apuder/TRS-IO/kicad/pmod/lb-80/lb-80.kicad_pcb

## KiCad design kicad/pmod/lb-80/lb-80.kicad_pcb (2024-11-14)

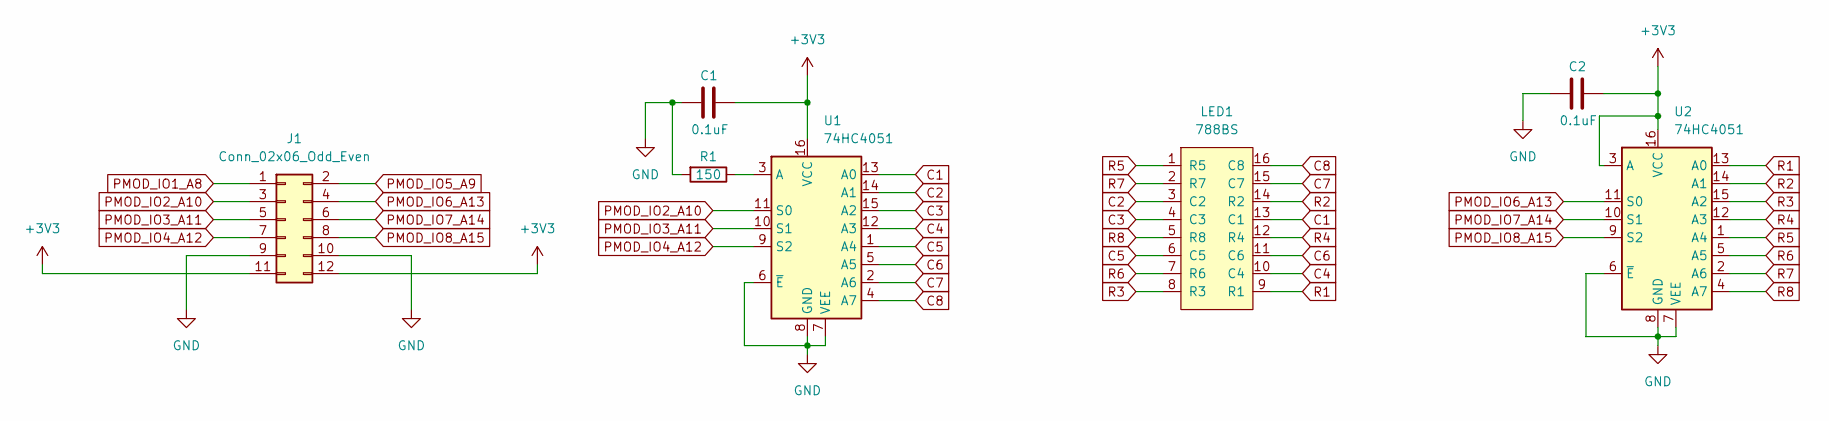
[picture p4: schematic lb-80.kicad_sch, LightBright-80]

Parts:
C1, C2: 0.1uF; C_0805_2012Metric_Pad1.18x1.45mm_HandSolder
J1: Conn_02x06_Odd_Even; PinSocket_2x06_P2.54mm_Vertical; LCSC C358728
LED1: 788BS
R1: 150; R_0805_2012Metric_Pad1.20x1.40mm_HandSolder
U1, U2: 74HC4051; TSSOP-16_4.4x5mm_P0.65mm; LCSC C352826

Connections:
+3V3: C1.1, C2.1, J1.11, J1.12, U1.16 (VCC), U2.3 (A), U2.16 (VCC)
C1: LED1.13 (C1), U1.13 (A0)
C2: LED1.3 (C2), U1.14 (A1)
C3: LED1.4 (C3), U1.15 (A2)
C4: LED1.10 (C4), U1.12 (A3)
C5: LED1.6 (C5), U1.1 (A4)
C6: LED1.11 (C6), U1.5 (A5)
C7: LED1.15 (C7), U1.2 (A6)
C8: LED1.16 (C8), U1.4 (A7)
GND: C1.2, C2.2, J1.9, J1.10, R1.2, U1.6 (~E), U1.7 (VEE), U1.8 (GND), U2.6 (~E), U2.7 (VEE), U2.8 (GND)
unnamed: R1.1, U1.3 (A)
PMOD_IO1_A8: J1.1
PMOD_IO2_A10: J1.3, U1.11 (S0)
PMOD_IO3_A11: J1.5, U1.10 (S1)
PMOD_IO4_A12: J1.7, U1.9 (S2)
PMOD_IO5_A9: J1.2
PMOD_IO6_A13: J1.4, U2.11 (S0)
PMOD_IO7_A14: J1.6, U2.10 (S1)
PMOD_IO8_A15: J1.8, U2.9 (S2)
R1: LED1.9 (R1), U2.13 (A0)
R2: LED1.14 (R2), U2.14 (A1)
R3: LED1.8 (R3), U2.15 (A2)
R4: LED1.12 (R4), U2.12 (A3)
R5: LED1.1 (R5), U2.1 (A4)
R6: LED1.7 (R6), U2.5 (A5)
R7: LED1.2 (R7), U2.2 (A6)
R8: LED1.5 (R8), U2.4 (A7)

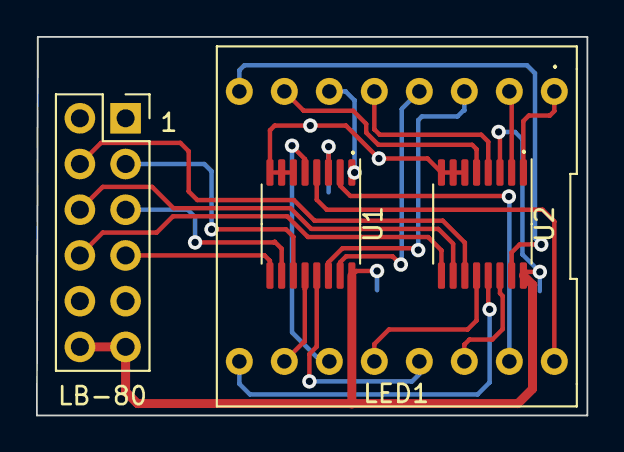
[picture p5: board lb-80.kicad_pcb from above]

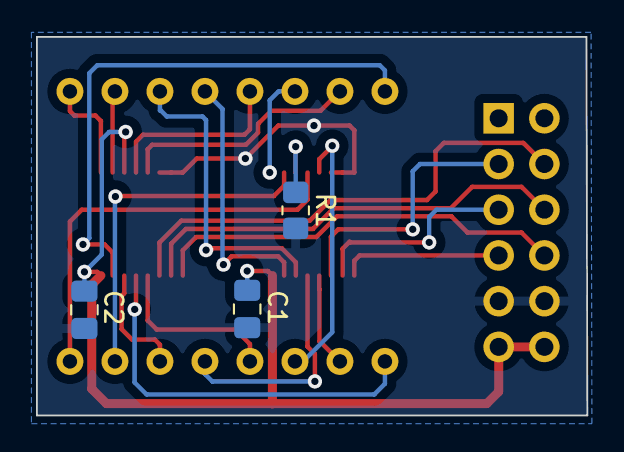
[picture p6: board lb-80.kicad_pcb from below]

Board: 2 copper layers, 30.6 x 21.0 mm, 7 parts (3 on the bottom side), 25 nets.
