apuder/TRS-IO/kicad/m3/v2.2b/TRS-IO-M3.kicad_pcb

## KiCad design kicad/m3/v2.2b/TRS-IO-M3.kicad_pcb (2023-07-12)

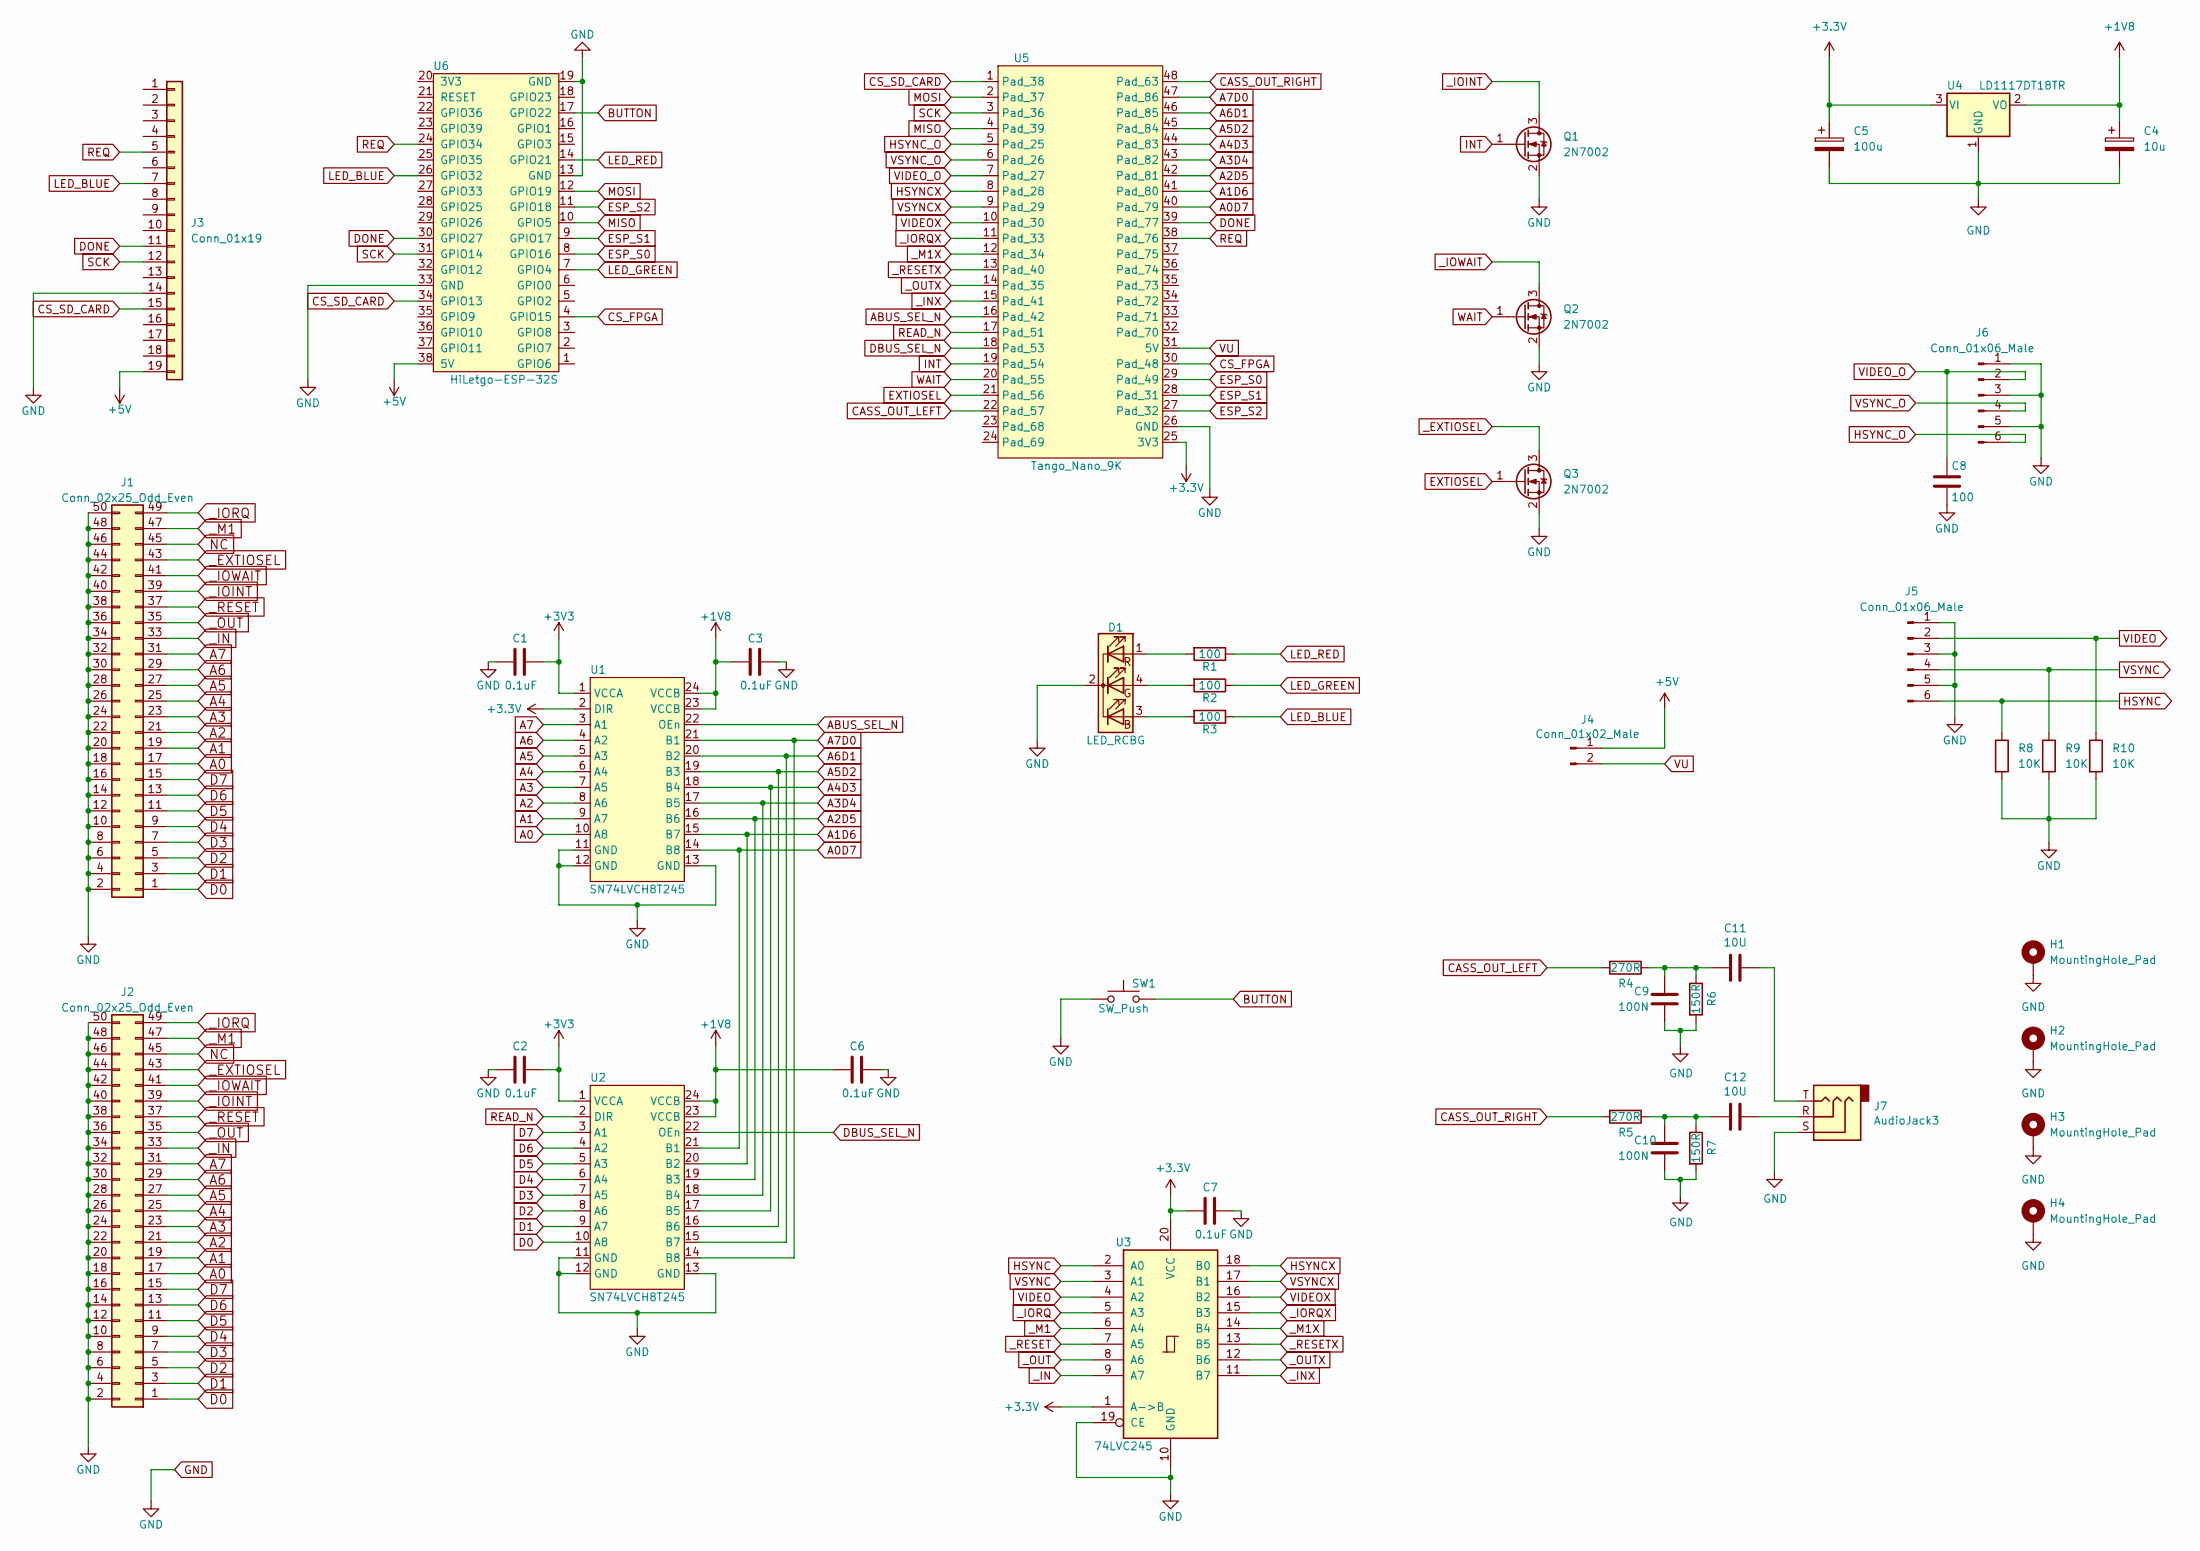
[picture p7: schematic TRS-IO-M3.kicad_sch, TRS-IO-M3 HIRES]

Parts:
C1, C2, C3, C6, C7: 0.1uF; C_0805_2012Metric_Pad1.18x1.45mm_HandSolder
C4: 10u; C_1206_3216Metric_Pad1.33x1.80mm_HandSolder
C5: 100u; C_1206_3216Metric_Pad1.33x1.80mm_HandSolder
C8: 100; C_0805_2012Metric_Pad1.18x1.45mm_HandSolder
C9, C10: 100N; C_0805_2012Metric_Pad1.18x1.45mm_HandSolder
C11, C12: 10U; C_1206_3216Metric_Pad1.33x1.80mm_HandSolder
D1: LED_RCBG; LED_D5.0mm-4_RGB
H1, H2, H3, H4: MountingHole_Pad; MountingHole_3mm_Pad_Via
J1: Conn_02x25_Odd_Even; EDGE50
J2: Conn_02x25_Odd_Even; Pin_Header_Straight_2x25_Pitch2.54mm
J3: Conn_01x19; PinHeader_1x19_P2.54mm_Vertical
J4: Conn_01x02_Male; PinHeader_1x02_P2.54mm_Vertical
J5, J6: Conn_01x06_Male; PinHeader_1x06_P2.54mm_Horizontal
J7: AudioJack3; Jack_3.5mm_CUI_SJ1-3535NG_Horizontal_CircularHoles
Q1, Q2, Q3: 2N7002; SOT-23
R1, R2, R3: 100; R_0805_2012Metric_Pad1.20x1.40mm_HandSolder
R4, R5: 270R; R_0805_2012Metric_Pad1.20x1.40mm_HandSolder
R6, R7: 150R; R_0805_2012Metric_Pad1.20x1.40mm_HandSolder
R8, R9, R10: 10K; R_0805_2012Metric_Pad1.20x1.40mm_HandSolder
SW1: SW_Push; SW_PUSH_6mm_H9.5mm
U1, U2: SN74LVCH8T245; TSSOP-24_4.4x7.8mm_P0.65mm
U3: 74LVC245; SSOP-20_5.3x7.2mm_P0.65mm_slim
U4: LD1117DT18TR; TO-252-3_TabPin2
U5: Tango_Nano_9K; DIP-48_W22.9mm
U6: HiLetgo-ESP-32S; DIP-38_W22.9mm

Connections:
+1V8: C3.2, C4.1, C6.2, U1.23 (VCCB), U1.24 (VCCB), U2.23 (VCCB), U2.24 (VCCB), U4.2 (VO)
+5V: J3.19, J4.1, U6.38 (5V)
A0: J1.17, J2.17, U1.10 (A8)
A0D7: U1.14 (B8), U2.21 (B1), U5.40 (Pad_79)
A1: J1.19, J2.19, U1.9 (A7)
A1D6: U1.15 (B7), U2.20 (B2), U5.41 (Pad_80)
A2: J1.21, J2.21, U1.8 (A6)
A2D5: U1.16 (B6), U2.19 (B3), U5.42 (Pad_81)
A3: J1.23, J2.23, U1.7 (A5)
A3D4: U1.17 (B5), U2.18 (B4), U5.43 (Pad_82)
A4: J1.25, J2.25, U1.6 (A4)
A4D3: U1.18 (B4), U2.17 (B5), U5.44 (Pad_83)
A5: J1.27, J2.27, U1.5 (A3)
A5D2: U1.19 (B3), U2.16 (B6), U5.45 (Pad_84)
A6: J1.29, J2.29, U1.4 (A2)
A6D1: U1.20 (B2), U2.15 (B7), U5.46 (Pad_85)
A7: J1.31, J2.31, U1.3 (A1)
A7D0: U1.21 (B1), U2.14 (B8), U5.47 (Pad_86)
ABUS_SEL_N: U1.22 (OEn), U5.16 (Pad_42)
BUTTON: SW1.2, U6.17 (GPIO22)
CASS_OUT_LEFT: R4.2, U5.22 (Pad_57)
CASS_OUT_RIGHT: R5.2, U5.48 (Pad_63)
CS_FPGA: U5.30 (Pad_48), U6.4 (GPIO15)
CS_SD_CARD: J3.15, U5.1 (Pad_38), U6.34 (GPIO13)
D0: J1.1, J2.1, U2.10 (A8)
D1: J1.3, J2.3, U2.9 (A7)
D2: J1.5, J2.5, U2.8 (A6)
D3: J1.7, J2.7, U2.7 (A5)
D4: J1.9, J2.9, U2.6 (A4)
D5: J1.11, J2.11, U2.5 (A3)
D6: J1.13, J2.13, U2.4 (A2)
D7: J1.15, J2.15, U2.3 (A1)
DBUS_SEL_N: U2.22 (OEn), U5.18 (Pad_53)
DONE: J3.11, U5.39 (Pad_77), U6.30 (GPIO27)
ESP_S0: U5.29 (Pad_49), U6.8 (GPIO16)
ESP_S1: U5.28 (Pad_31), U6.9 (GPIO17)
ESP_S2: U5.27 (Pad_32), U6.11 (GPIO18)
EXTIOSEL: Q3.1 (G), U5.21 (Pad_56)
GND: C1.2, C2.2, C3.1, C4.2, C5.2, C6.1, C7.1, C8.2, C9.2, C10.2, D1.2 (K), H1.1, H2.1, H3.1, H4.1, J1.2, J1.4, J1.6, J1.8, J1.10, J1.12, J1.14, J1.16, J1.18, J1.20, J1.22, J1.24, J1.26, J1.28, J1.30, J1.32, J1.34, J1.36, J1.38, J1.40, J1.42, J1.44, J1.46, J1.48, J1.50, J2.2, J2.4, J2.6, J2.8, J2.10, J2.12, J2.14, J2.16, J2.18, J2.20, J2.22, J2.24, J2.26, J2.28, J2.30, J2.32, J2.34, J2.36, J2.38, J2.40, J2.42, J2.44, J2.46, J2.48, J2.50, J3.14, J5.1, J5.3, J5.5, J6.1, J6.3, J6.5, J7.S, Q1.2 (S), Q2.2 (S), Q3.2 (S), R6.2, R7.2, R8.2, R9.2, R10.2, SW1.1, U1.11 (GND), U1.12 (GND), U1.13 (GND), U2.11 (GND), U2.12 (GND), U2.13 (GND), U3.10 (GND), U3.19 (CE), U4.1 (GND), U5.26 (GND), U6.13 (GND), U6.19 (GND), U6.33 (GND)
HSYNC: J5.6, R8.1, U3.2 (A0)
HSYNCX: U3.18 (B0), U5.8 (Pad_28)
HSYNC_O: J6.6, U5.5 (Pad_25)
INT: Q1.1 (G), U5.19 (Pad_54)
LED_BLUE: J3.7, R3.1, U6.26 (GPIO32)
LED_GREEN: R2.1, U6.7 (GPIO4)
LED_RED: R1.1, U6.14 (GPIO21)
MISO: U5.4 (Pad_39), U6.10 (GPIO5)
MOSI: U5.2 (Pad_37), U6.12 (GPIO19)
NC: J1.45, J2.45
unnamed: C10.1, C12.2, R5.1, R7.1
unnamed: C11.1, J7.T
unnamed: C9.1, C11.2, R4.1, R6.1
unnamed: C12.1, J7.R
unnamed: D1.1 (RA), R1.2
unnamed: D1.3 (BA), R3.2
unnamed: D1.4 (GA), R2.2
READ_N: U2.2 (DIR), U5.17 (Pad_51)
REQ: J3.5, U5.38 (Pad_76), U6.24 (GPIO34)
SCK: J3.12, U5.3 (Pad_36), U6.31 (GPIO14)
VIDEO: J5.2, R10.1, U3.4 (A2)
VIDEOX: U3.16 (B2), U5.10 (Pad_30)
VIDEO_O: C8.1, J6.2, U5.7 (Pad_27)
VSYNC: J5.4, R9.1, U3.3 (A1)
VSYNCX: U3.17 (B1), U5.9 (Pad_29)
VSYNC_O: J6.4, U5.6 (Pad_26)
VU: J4.2, U5.31 (5V)
WAIT: Q2.1 (G), U5.20 (Pad_55)
_EXTIOSEL: J1.43, J2.43, Q3.3 (D)
_IN: J1.33, J2.33, U3.9 (A7)
_INX: U3.11 (B7), U5.15 (Pad_41)
_IOINT: J1.39, J2.39, Q1.3 (D)
_IORQ: J1.49, J2.49, U3.5 (A3)
_IORQX: U3.15 (B3), U5.11 (Pad_33)
_IOWAIT: J1.41, J2.41, Q2.3 (D)
_M1: J1.47, J2.47, U3.6 (A4)
_M1X: U3.14 (B4), U5.12 (Pad_34)
_OUT: J1.35, J2.35, U3.8 (A6)
_OUTX: U3.12 (B6), U5.14 (Pad_35)
_RESET: J1.37, J2.37, U3.7 (A5)
_RESETX: U3.13 (B5), U5.13 (Pad_40)

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
