apuder/TRS-IO/kicad/m3/v2.2b/TRS-IO-M3.kicad_pcb

## KiCad design kicad/m3/v2.2b/TRS-IO-M3.kicad_pcb (continued)

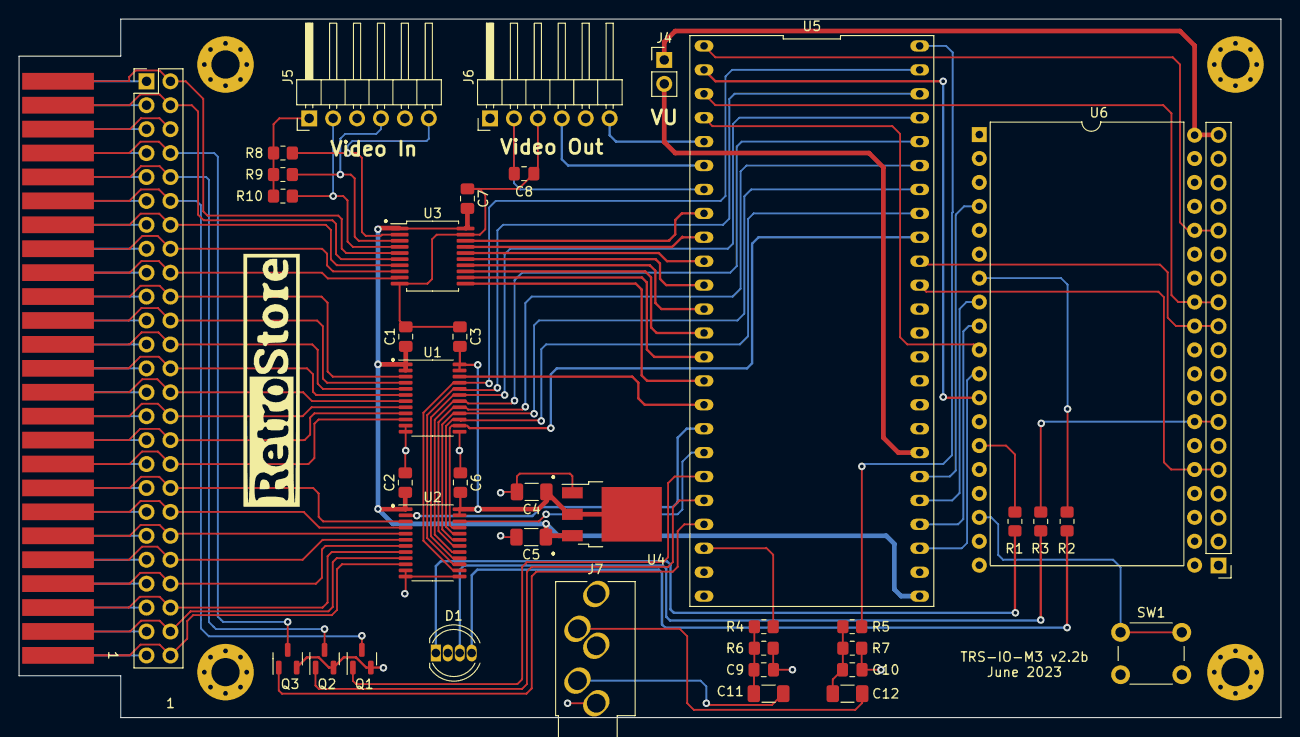
[picture p8: board TRS-IO-M3.kicad_pcb from above]

Board: 2 copper layers, 134.0 x 74.2 mm, 45 parts (0 on the bottom side), 81 nets.

Other parts of the board:
G1: LOGO
