apuder/TRS-IO/kicad/m1/v1.4/TRS-IO-M1.kicad_pcb

## KiCad design kicad/m1/v1.4/TRS-IO-M1.kicad_pcb (2023-07-01)

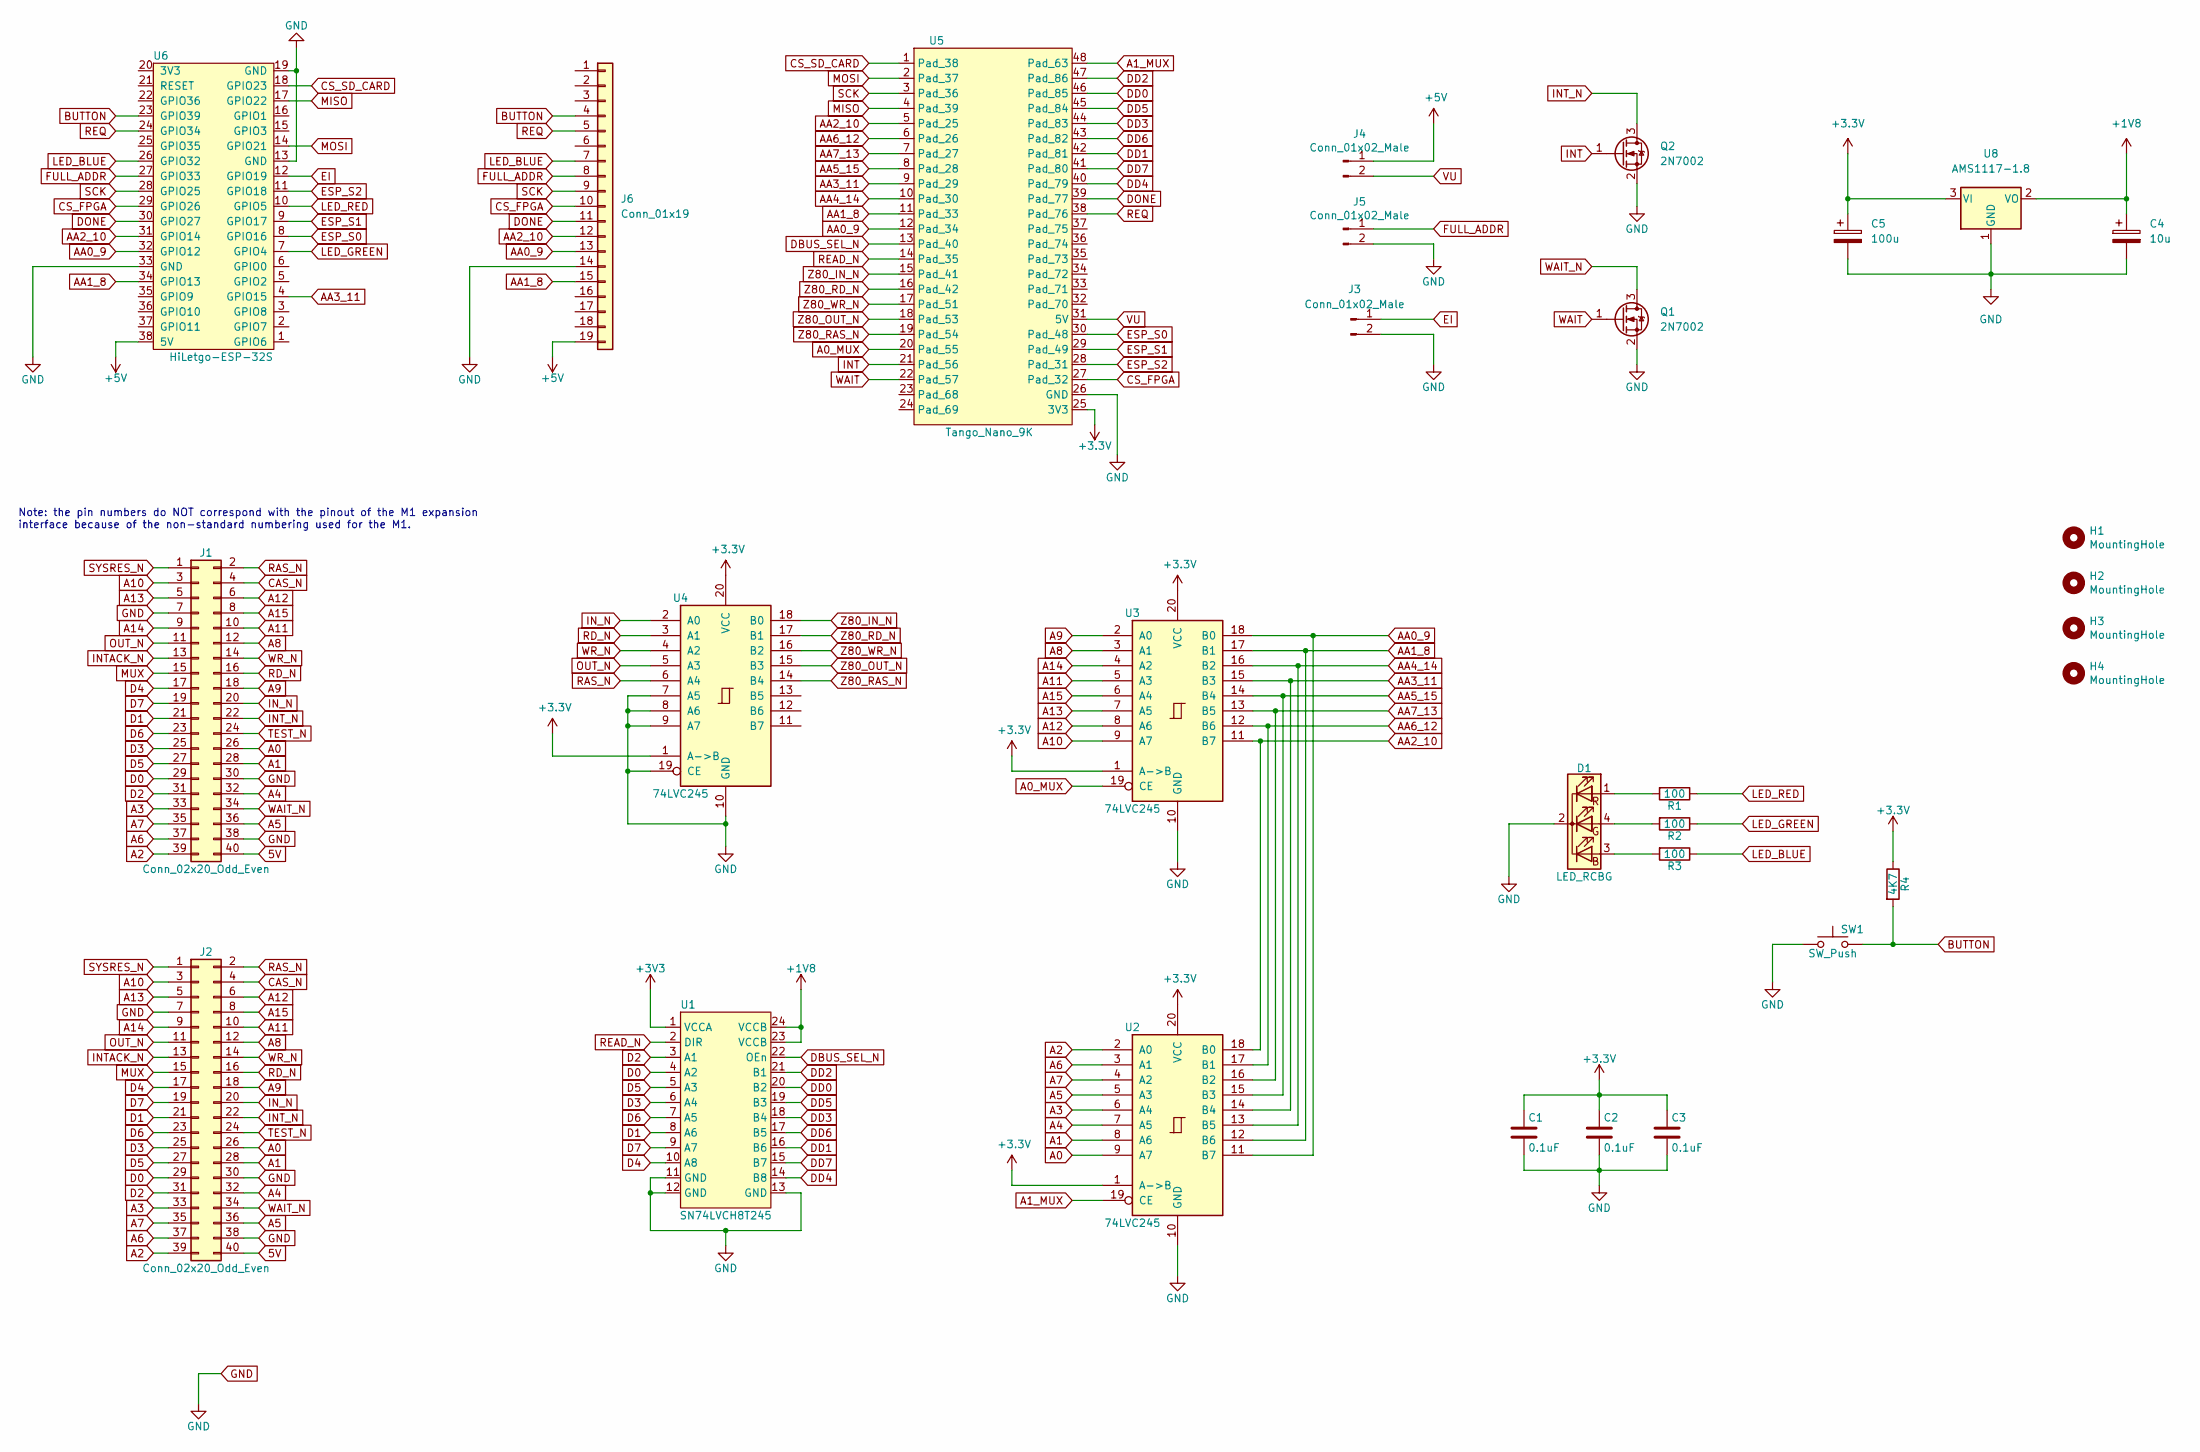
[picture p9: schematic TRS-IO-M1.kicad_sch]

Parts:
C1, C2, C3: 0.1uF; C_0805_2012Metric_Pad1.18x1.45mm_HandSolder
C4: 10u; C_1206_3216Metric_Pad1.33x1.80mm_HandSolder
C5: 100u; C_1206_3216Metric_Pad1.33x1.80mm_HandSolder
D1: LED_RCBG; LED_D5.0mm-4_RGB
H1, H2, H3, H4: MountingHole; MountingHole_3mm_Pad_Via
J1: Conn_02x20_Odd_Even; PinHeader_2x20_P2.54mm_Vertical
J2: Conn_02x20_Odd_Even; TRSEDGE
J3, J4, J5: Conn_01x02_Male; PinHeader_1x02_P2.54mm_Vertical
J6: Conn_01x19; PinHeader_1x19_P2.54mm_Vertical
Q1, Q2: 2N7002; SOT-23
R1, R2, R3: 100; R_0805_2012Metric_Pad1.20x1.40mm_HandSolder
R4: 4K7; R_0805_2012Metric_Pad1.20x1.40mm_HandSolder
SW1: SW_Push; SW_PUSH_6mm_H9.5mm
U1: SN74LVCH8T245; TSSOP-24_4.4x7.8mm_P0.65mm
U2, U3, U4: 74LVC245; SSOP-20_5.3x7.2mm_P0.65mm_slim
U5: Tango_Nano_9K; DIP-48_W22.9mm
U6: HiLetgo-ESP-32S; DIP-38_W22.9mm
U8: AMS1117-1.8; SOT-223-3_TabPin2

Connections:
5V: J1.40, J2.40
+1V8: C4.1, U1.23 (VCCB), U1.24 (VCCB), U8.2 (VO)
+5V: J4.1, J6.19, U6.38 (5V)
A0: J1.26, J2.26, U2.9 (A7)
A0_MUX: U3.19 (CE), U5.20 (Pad_55)
A1: J1.28, J2.28, U2.8 (A6)
A1_MUX: U2.19 (CE), U5.48 (Pad_63)
A2: J1.39, J2.39, U2.2 (A0)
A3: J1.33, J2.33, U2.6 (A4)
A4: J1.32, J2.32, U2.7 (A5)
A5: J1.36, J2.36, U2.5 (A3)
A6: J1.37, J2.37, U2.3 (A1)
A7: J1.35, J2.35, U2.4 (A2)
A8: J1.12, J2.12, U3.3 (A1)
A9: J1.18, J2.18, U3.2 (A0)
A10: J1.3, J2.3, U3.9 (A7)
A11: J1.10, J2.10, U3.5 (A3)
A12: J1.6, J2.6, U3.8 (A6)
A13: J1.5, J2.5, U3.7 (A5)
A14: J1.9, J2.9, U3.4 (A2)
A15: J1.8, J2.8, U3.6 (A4)
AA0_9: J6.13, U2.11 (B7), U3.18 (B0), U5.12 (Pad_34), U6.32 (GPIO12)
AA1_8: J6.15, U2.12 (B6), U3.17 (B1), U5.11 (Pad_33), U6.34 (GPIO13)
AA2_10: J6.12, U2.18 (B0), U3.11 (B7), U5.5 (Pad_25), U6.31 (GPIO14)
AA3_11: U2.14 (B4), U3.15 (B3), U5.9 (Pad_29), U6.4 (GPIO15)
AA4_14: U2.13 (B5), U3.16 (B2), U5.10 (Pad_30)
AA5_15: U2.15 (B3), U3.14 (B4), U5.8 (Pad_28)
AA6_12: U2.17 (B1), U3.12 (B6), U5.6 (Pad_26)
AA7_13: U2.16 (B2), U3.13 (B5), U5.7 (Pad_27)
BUTTON: J6.4, R4.2, SW1.2, U6.23 (GPIO39)
CAS_N: J1.4, J2.4
CS_FPGA: J6.10, U5.27 (Pad_32), U6.29 (GPIO26)
CS_SD_CARD: U5.1 (Pad_38), U6.18 (GPIO23)
D0: J1.29, J2.29, U1.4 (A2)
D1: J1.21, J2.21, U1.8 (A6)
D2: J1.31, J2.31, U1.3 (A1)
D3: J1.25, J2.25, U1.6 (A4)
D4: J1.17, J2.17, U1.10 (A8)
D5: J1.27, J2.27, U1.5 (A3)
D6: J1.23, J2.23, U1.7 (A5)
D7: J1.19, J2.19, U1.9 (A7)
DBUS_SEL_N: U1.22 (OEn), U5.13 (Pad_40)
DD0: U1.20 (B2), U5.46 (Pad_85)
DD1: U1.16 (B6), U5.42 (Pad_81)
DD2: U1.21 (B1), U5.47 (Pad_86)
DD3: U1.18 (B4), U5.44 (Pad_83)
DD4: U1.14 (B8), U5.40 (Pad_79)
DD5: U1.19 (B3), U5.45 (Pad_84)
DD6: U1.17 (B5), U5.43 (Pad_82)
DD7: U1.15 (B7), U5.41 (Pad_80)
DONE: J6.11, U5.39 (Pad_77), U6.30 (GPIO27)
EI: J3.1, U6.12 (GPIO19)
ESP_S0: U5.30 (Pad_48), U6.8 (GPIO16)
ESP_S1: U5.29 (Pad_49), U6.9 (GPIO17)
ESP_S2: U5.28 (Pad_31), U6.11 (GPIO18)
FULL_ADDR: J5.1, J6.8, U6.27 (GPIO33)
GND: C1.2, C2.2, C3.2, C4.2, C5.2, D1.2 (K), J1.7, J1.30, J1.38, J2.7, J2.30, J2.38, J3.2, J5.2, J6.14, Q1.2 (S), Q2.2 (S), SW1.1, U1.11 (GND), U1.12 (GND), U1.13 (GND), U2.10 (GND), U3.10 (GND), U4.7 (A5), U4.8 (A6), U4.9 (A7), U4.10 (GND), U4.19 (CE), U5.26 (GND), U6.13 (GND), U6.19 (GND), U6.33 (GND), U8.1 (GND)
INT: Q2.1 (G), U5.21 (Pad_56)
INTACK_N: J1.13, J2.13
INT_N: J1.22, J2.22, Q2.3 (D)
IN_N: J1.20, J2.20, U4.2 (A0)
LED_BLUE: J6.7, R3.1, U6.26 (GPIO32)
LED_GREEN: R2.1, U6.7 (GPIO4)
LED_RED: R1.1, U6.10 (GPIO5)
MISO: U5.4 (Pad_39), U6.17 (GPIO22)
MOSI: U5.2 (Pad_37), U6.14 (GPIO21)
MUX: J1.15, J2.15
unnamed: D1.1 (RA), R1.2
unnamed: D1.3 (BA), R3.2
unnamed: D1.4 (GA), R2.2
OUT_N: J1.11, J2.11, U4.5 (A3)
RAS_N: J1.2, J2.2, U4.6 (A4)
RD_N: J1.16, J2.16, U4.3 (A1)
READ_N: U1.2 (DIR), U5.14 (Pad_35)
REQ: J6.5, U5.38 (Pad_76), U6.24 (GPIO34)
SCK: J6.9, U5.3 (Pad_36), U6.28 (GPIO25)
SYSRES_N: J1.1, J2.1
TEST_N: J1.24, J2.24
VU: J4.2, U5.31 (5V)
WAIT: Q1.1 (G), U5.22 (Pad_57)
WAIT_N: J1.34, J2.34, Q1.3 (D)
WR_N: J1.14, J2.14, U4.4 (A2)
Z80_IN_N: U4.18 (B0), U5.15 (Pad_41)
Z80_OUT_N: U4.15 (B3), U5.18 (Pad_53)
Z80_RAS_N: U4.14 (B4), U5.19 (Pad_54)
Z80_RD_N: U4.17 (B1), U5.16 (Pad_42)
Z80_WR_N: U4.16 (B2), U5.17 (Pad_51)

Notes on the sheet:
Note: the pin numbers do NOT correspond with the pinout of the M1 expansion interface because of the non-standard numbering used for the M1.

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
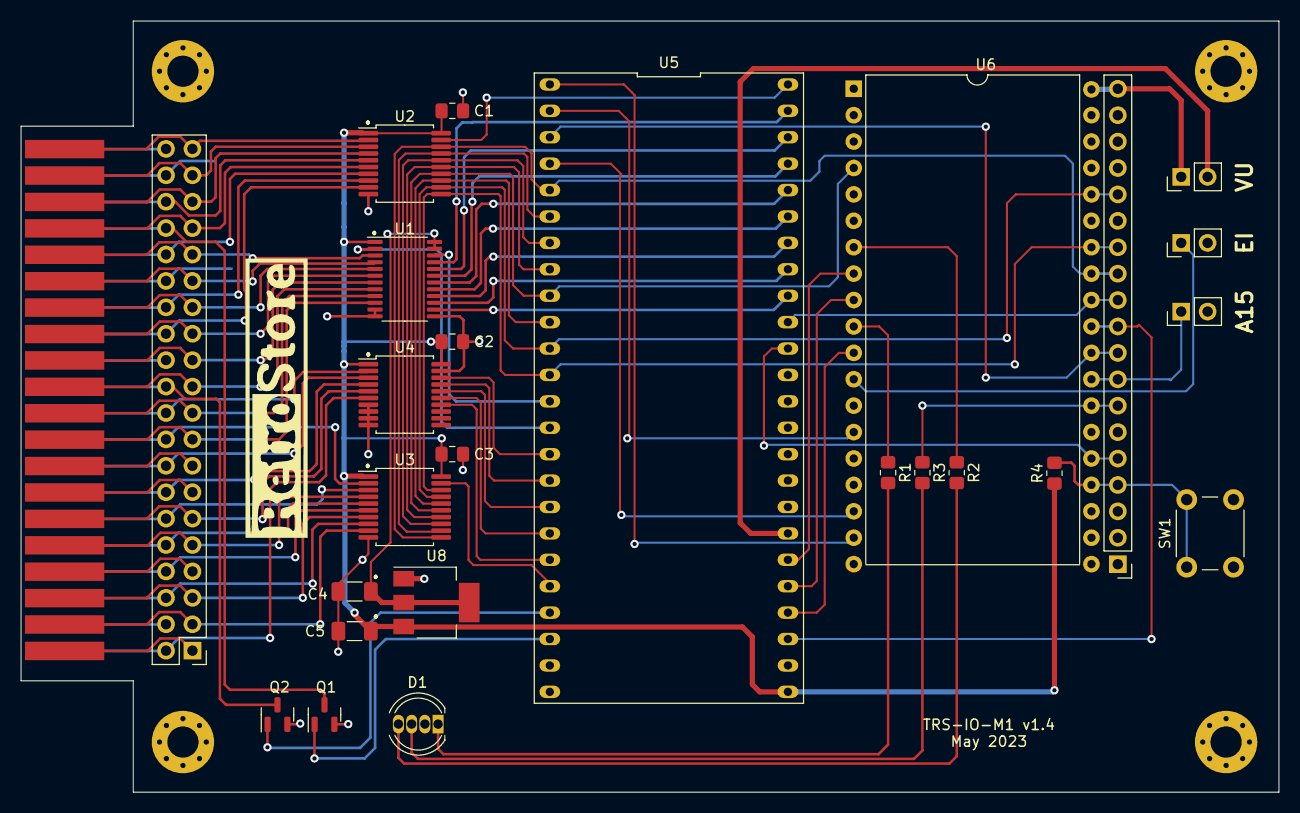
[picture p10: board kicad/m1/v1.4/TRS-IO-M1.kicad_pcb from above]

Board: 2 copper layers, 121.0 x 74.2 mm, 31 parts (0 on the bottom side), 88 nets.

Other parts of the board:
G1: LOGO
