apuder/TRS-IO/kicad/m3/v1.1/TRSIO.kicad_pcb

## KiCad design kicad/m3/v1.1/TRSIO.kicad_pcb (2021-12-25, an earlier design)

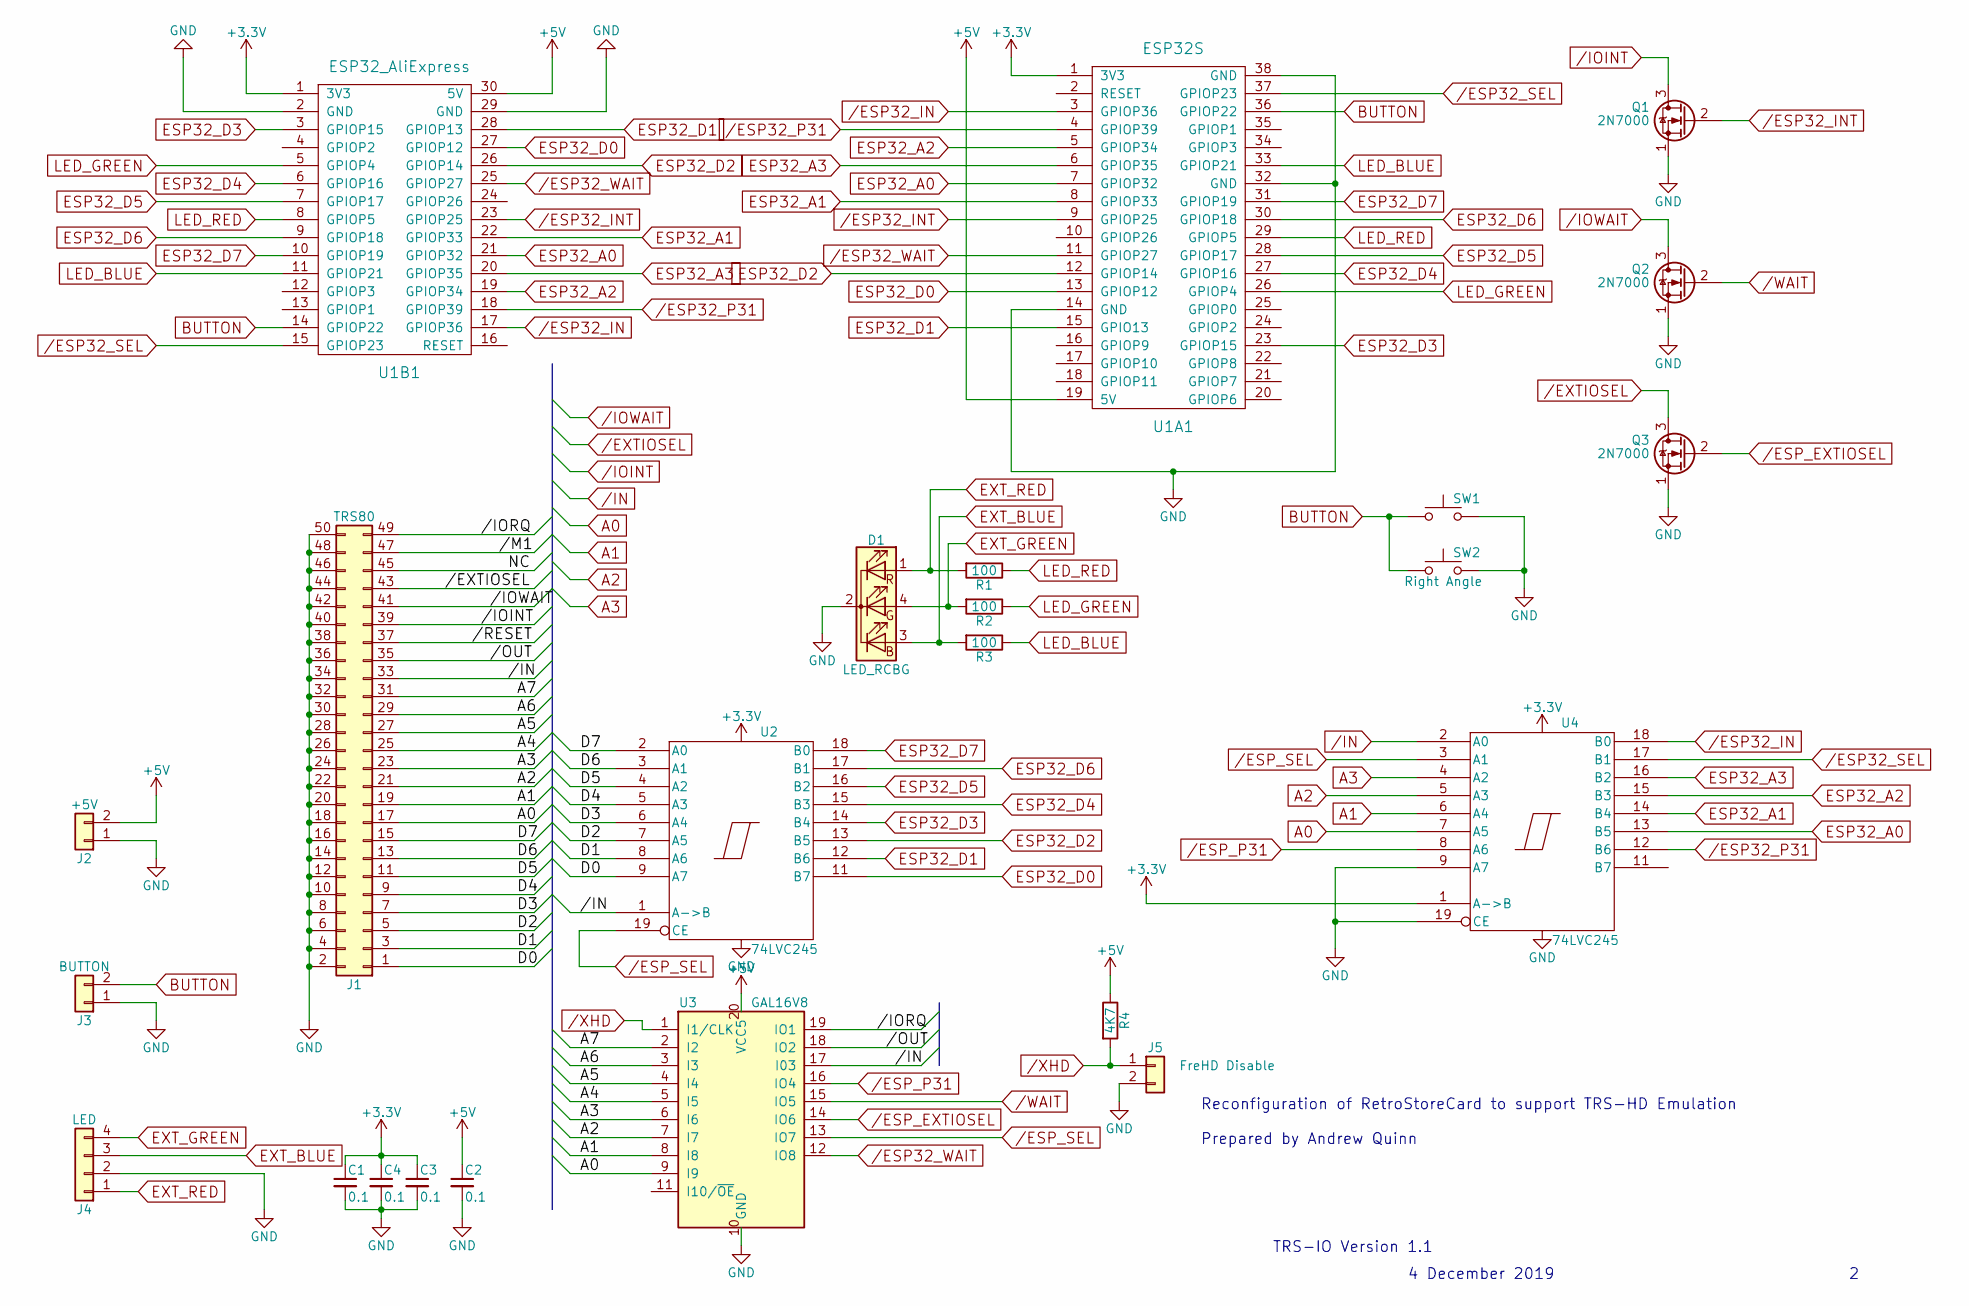
[picture p13: schematic TRSIO.sch]

Parts:
C1, C2, C3, C4: 0.1; C_Disc_D3.0mm_W2.0mm_P2.50mm
D1: LED_RCBG; LED_D5.0mm-4
J1: TRS80; Pin_Header_Straight_2x25_Pitch2.54mm
J2: +5V; Pin_Header_Straight_1x02_Pitch2.54mm
J3: BUTTON; Pin_Header_Straight_1x02_Pitch2.54mm
J4: LED; Pin_Header_Straight_1x04_Pitch2.54mm
J5: FreHD Disable; Pin_Header_Straight_1x02_Pitch2.54mm
Q1, Q2, Q3: 2N7000; TO-92_Molded_Narrow
R1, R2, R3: 100; R_Axial_DIN0207_L6.3mm_D2.5mm_P7.62mm_Horizontal
R4: 4K7; R_Axial_DIN0207_L6.3mm_D2.5mm_P7.62mm_Horizontal
SW1: SW_Push; SW_PUSH_6mm_h9.5mm
SW2: Right Angle; SW_Tactile_SPST_Angled_PTS645Vx31-2LFS
U1A1: ESP32S; DIP-38_W22.9mm
U1B1: ESP32_AliExpress; DIP-30_W25.4mm
U2, U4: 74LVC245; DIP-20_W7.62mm
U3: GAL16V8; DIP-20_W7.62mm

Connections:
+3V3: C1.1, C3.1, C4.1, U1A1.1 (3V3), U1B1.1 (3V3), U2.20 (VCC), U4.1 (A->B), U4.20 (VCC)
+5V: C2.1, J2.2, R4.1, U1A1.19 (5V), U1B1.30 (5V), U3.20 (VCC5)
//IORQ: J1.49, U3.19 (IO1)
//M1: J1.47
//OUT: J1.35, U3.18 (IO2)
//RESET: J1.37
/A4: J1.25, U3.5 (I5)
/A5: J1.27, U3.4 (I4)
/A6: J1.29, U3.3 (I3)
/A7: J1.31, U3.2 (I2)
/D0: J1.1, U2.9 (A7)
/D1: J1.3, U2.8 (A6)
/D2: J1.5, U2.7 (A5)
/D3: J1.7, U2.6 (A4)
/D4: J1.9, U2.5 (A3)
/D5: J1.11, U2.4 (A2)
/D6: J1.13, U2.3 (A1)
/D7: J1.15, U2.2 (A0)
/ESP32_IN: U1A1.3 (GPIOP36), U1B1.17 (GPIOP36), U4.18 (B0)
/ESP32_INT: Q1.2 (G), U1A1.9 (GPIOP25), U1B1.23 (GPIOP25)
/ESP32_P31: U1A1.4 (GPIOP39), U1B1.18 (GPIOP39), U4.12 (B6)
/ESP32_SEL: U1A1.37 (GPIOP23), U1B1.15 (GPIOP23), U4.17 (B1)
/ESP32_WAIT: U1A1.11 (GPIOP27), U1B1.25 (GPIOP27), U3.12 (IO8)
/ESP_EXTIOSEL: Q3.2 (G), U3.14 (IO6)
/ESP_P31: U3.16 (IO4), U4.8 (A6)
/ESP_SEL: U2.19 (CE), U3.13 (IO7), U4.3 (A1)
/EXTIOSEL: J1.43, Q3.3 (D)
/IN: J1.33, U2.1 (A->B), U3.17 (I03), U4.2 (A0)
/IOINT: J1.39, Q1.3 (D)
/IOWAIT: J1.41, Q2.3 (D)
/NC: J1.45
/WAIT: Q2.2 (G), U3.15 (IO5)
/XHD: J5.1, R4.2, U3.1 (I1/CLK)
A0: J1.17, U3.9 (I9), U4.7 (A5)
A1: J1.19, U3.8 (I8), U4.6 (A4)
A2: J1.21, U3.7 (I7), U4.5 (A3)
A3: J1.23, U3.6 (I6), U4.4 (A2)
BUTTON: J3.2, SW1.1, SW2.1, U1A1.36 (GPIOP22), U1B1.14 (GPIOP22)
ESP32_A0: U1A1.7 (GPIOP32), U1B1.21 (GPIOP32), U4.13 (B5)
ESP32_A1: U1A1.8 (GPIOP33), U1B1.22 (GPIOP33), U4.14 (B4)
ESP32_A2: U1A1.5 (GPIOP34), U1B1.19 (GPIOP34), U4.15 (B3)
ESP32_A3: U1A1.6 (GPIOP35), U1B1.20 (GPIOP35), U4.16 (B2)
ESP32_D0: U1A1.13 (GPIOP12), U1B1.27 (GPIOP12), U2.11 (B7)
ESP32_D1: U1A1.15 (GPIO13), U1B1.28 (GPIOP13), U2.12 (B6)
ESP32_D2: U1A1.12 (GPIOP14), U1B1.26 (GPIOP14), U2.13 (B5)
ESP32_D3: U1A1.23 (GPIOP15), U1B1.3 (GPIOP15), U2.14 (B4)
ESP32_D4: U1A1.27 (GPIOP16), U1B1.6 (GPIOP16), U2.15 (B3)
ESP32_D5: U1A1.28 (GPIOP17), U1B1.7 (GPIOP17), U2.16 (B2)
ESP32_D6: U1A1.30 (GPIOP18), U1B1.9 (GPIOP18), U2.17 (B1)
ESP32_D7: U1A1.31 (GPIOP19), U1B1.10 (GPIOP19), U2.18 (B0)
EXT_BLUE: D1.3 (BA), J4.3, R3.2
EXT_GREEN: D1.4 (GA), J4.4, R2.2
EXT_RED: D1.1 (RA), J4.1, R1.2
GND: C1.2, C2.2, C3.2, C4.2, D1.2 (K), J1.2, J1.4, J1.6, J1.8, J1.10, J1.12, J1.14, J1.16, J1.18, J1.20, J1.22, J1.24, J1.26, J1.28, J1.30, J1.32, J1.34, J1.36, J1.38, J1.40, J1.42, J1.44, J1.46, J1.48, J1.50, J2.1, J3.1, J4.2, J5.2, Q1.1 (S), Q2.1 (S), Q3.1 (S), SW1.2, SW2.2, U1A1.14 (GND), U1A1.32 (GND), U1A1.38 (GND), U1B1.2 (GND), U1B1.29 (GND), U2.10 (GND), U3.10 (GND), U4.9 (A7), U4.10 (GND), U4.19 (CE)
LED_BLUE: R3.1, U1A1.33 (GPIOP21), U1B1.11 (GPIOP21)
LED_GREEN: R2.1, U1A1.26 (GPIOP4), U1B1.5 (GPIOP4)
LED_RED: R1.1, U1A1.29 (GPIOP5), U1B1.8 (GPIOP5)

Notes on the sheet:
Reconfiguration of RetroStoreCard to support TRS-HD Emulation Prepared by Andrew Quinn
4 December 2019
TRS-IO Version 1.1

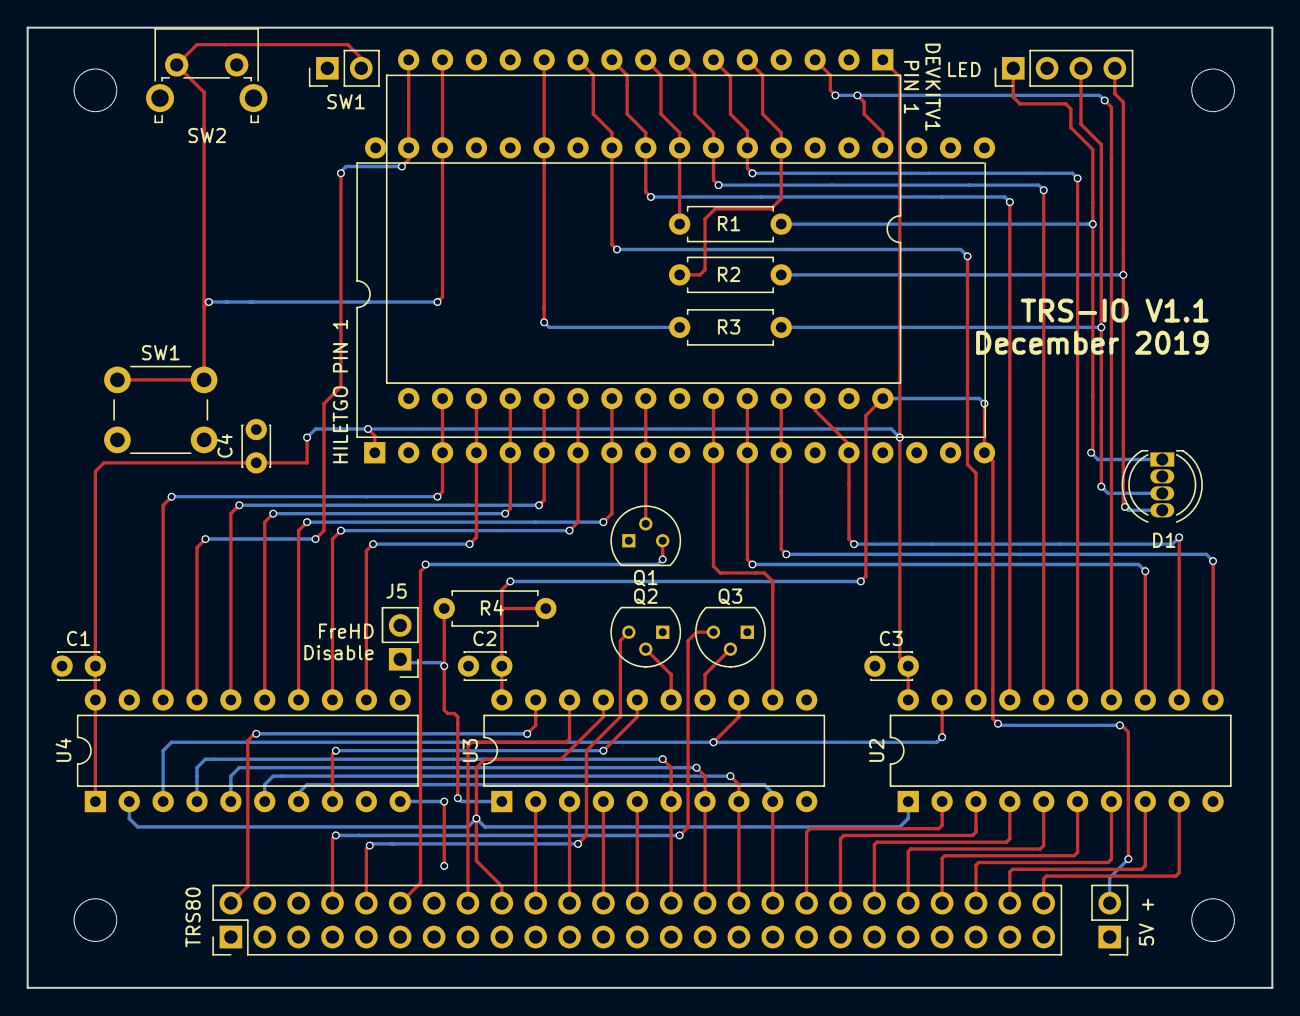
[picture p14: board kicad/m3/v1.1/TRSIO.kicad_pcb from above]

Board: 2 copper layers, 93.3 x 72.0 mm, 24 parts (0 on the bottom side), 54 nets.
