apuder/TRS-IO/kicad/m1/v1/TRS-IO-M1.kicad_pcb

## KiCad design kicad/m1/v1/TRS-IO-M1.kicad_pcb (2021-02-04, an earlier design)

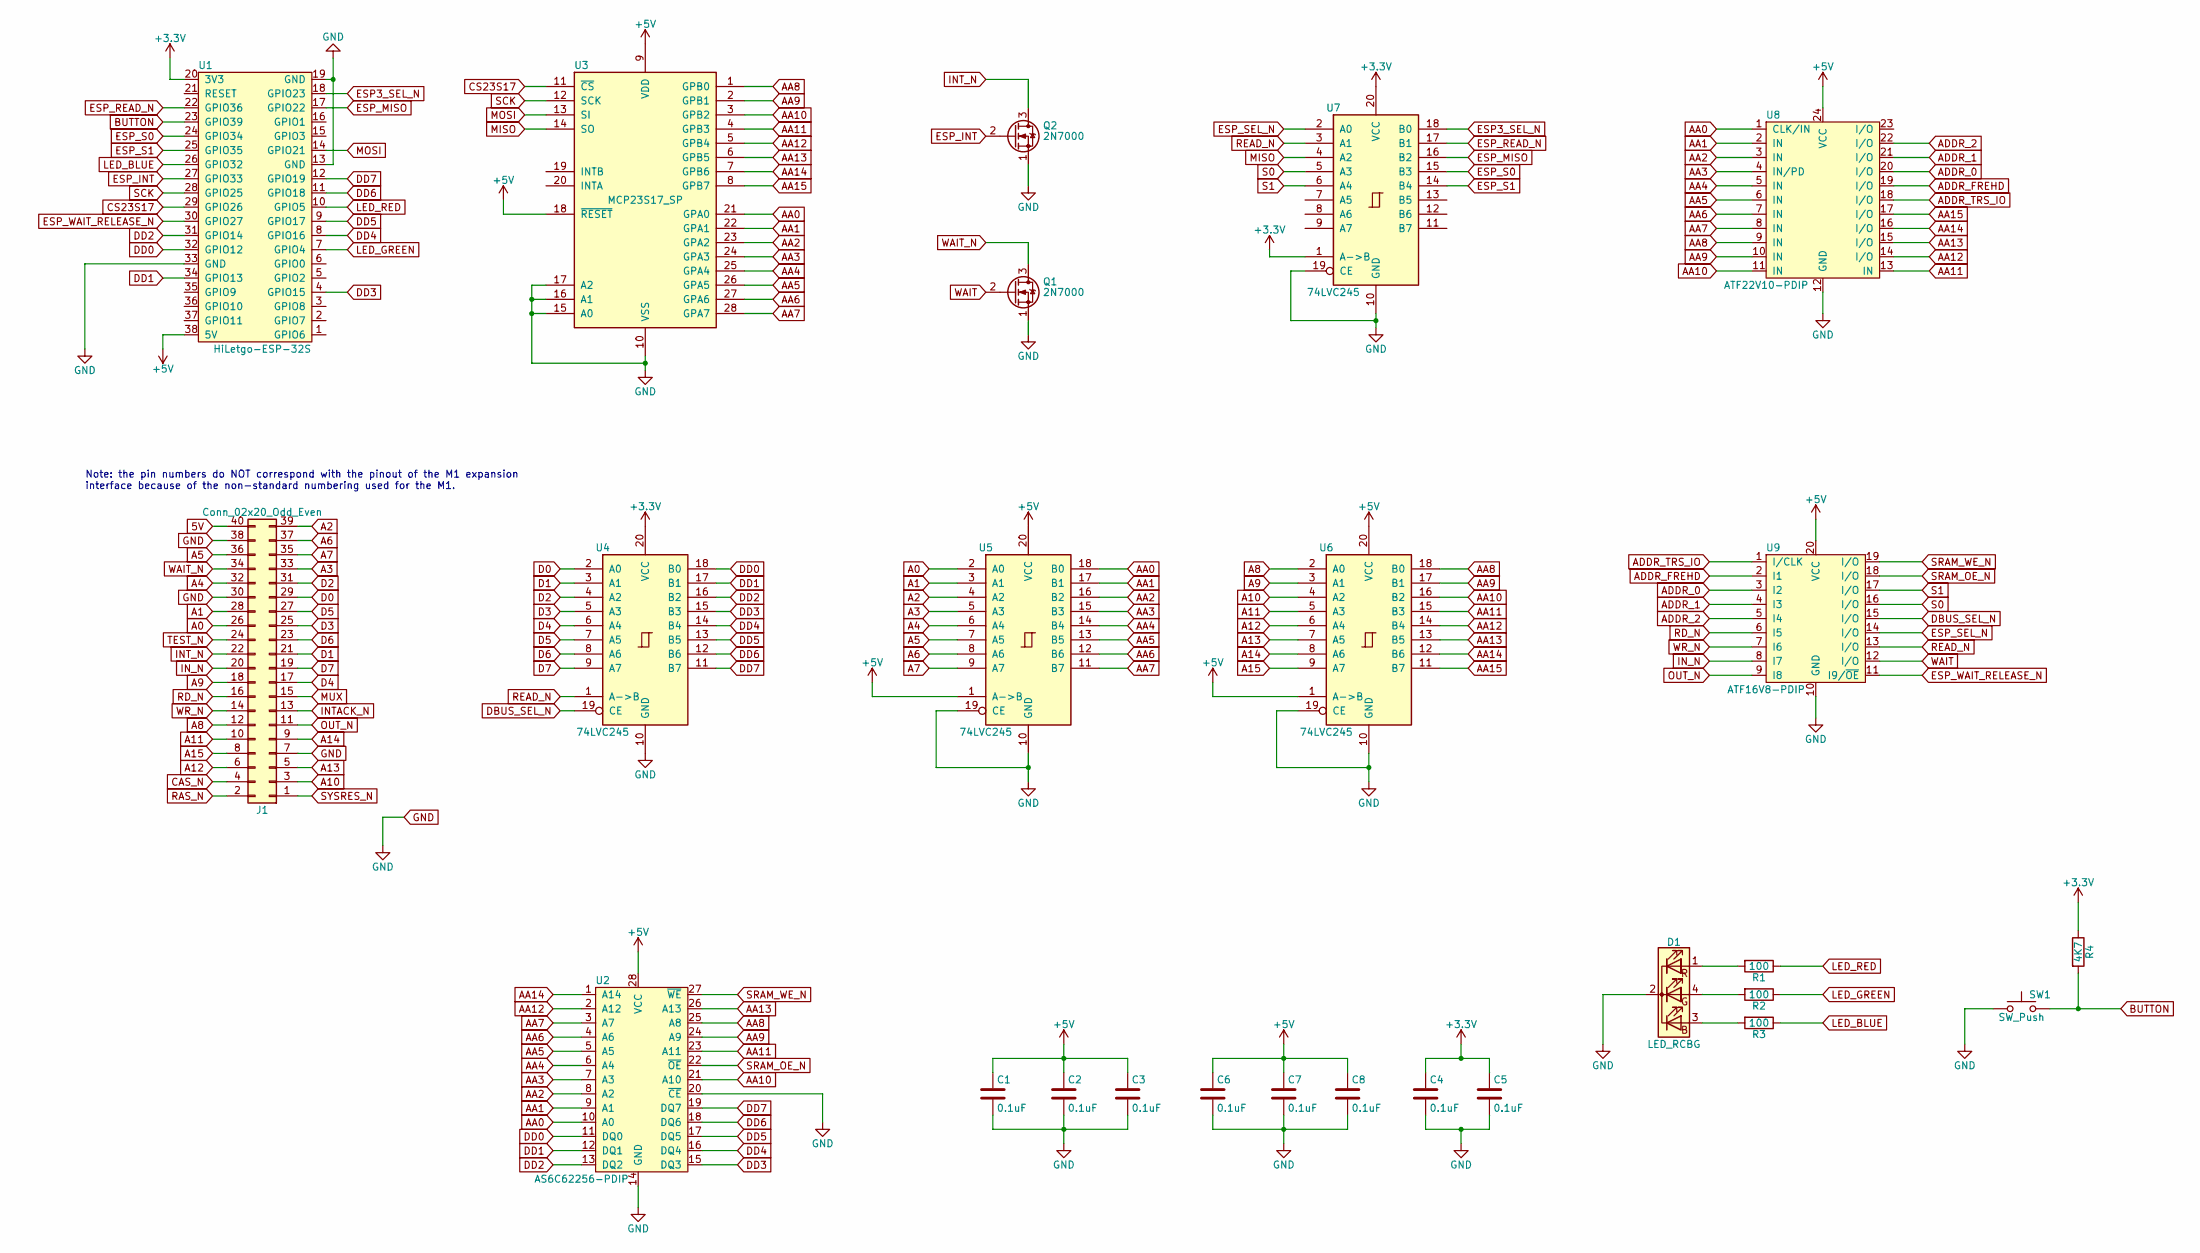
[picture p17: schematic TRS-IO-M1.sch, TRS-IO M1]

Parts:
C1, C2, C3, C4, C5, C6, C7, C8: 0.1uF; C_Disc_D3.0mm_W2.0mm_P2.50mm
D1: LED_RCBG; LED_D5.0mm-4_RGB
J1: Conn_02x20_Odd_Even; PinHeader_2x20_P2.54mm_Vertical
Q1, Q2: 2N7000; TO-92_Inline
R1, R2, R3: 100; R_Axial_DIN0207_L6.3mm_D2.5mm_P7.62mm_Horizontal
R4: 4K7; R_Axial_DIN0207_L6.3mm_D2.5mm_P7.62mm_Horizontal
SW1: SW_Push; SW_PUSH_6mm_H9.5mm
U1: HiLetgo-ESP-32S; DIP-38_W22.9mm
U2: AS6C62256-PDIP; DIP-28_W15.24mm
U3: MCP23S17_SP; DIP-28_W7.62mm
U4, U5, U6, U7: 74LVC245; DIP-20_W7.62mm
U8: ATF22V10-PDIP; DIP-24_W7.62mm
U9: ATF16V8-PDIP; DIP-20_W7.62mm

Connections:
5V: J1.40
+3V3: C4.1, C5.1, R4.1, U1.20 (3V3), U4.20 (VCC), U7.1 (A->B), U7.20 (VCC)
+5V: C1.1, C2.1, C3.1, C6.1, C7.1, C8.1, U1.38 (5V), U2.28 (VCC), U3.9 (VDD), U3.18 (~RESET~), U5.1 (A->B), U5.20 (VCC), U6.1 (A->B), U6.20 (VCC), U8.24 (VCC), U9.20 (VCC)
A0: J1.26, U5.2 (A0)
A1: J1.28, U5.3 (A1)
A2: J1.39, U5.4 (A2)
A3: J1.33, U5.5 (A3)
A4: J1.32, U5.6 (A4)
A5: J1.36, U5.7 (A5)
A6: J1.37, U5.8 (A6)
A7: J1.35, U5.9 (A7)
A8: J1.12, U6.2 (A0)
A9: J1.18, U6.3 (A1)
A10: J1.3, U6.4 (A2)
A11: J1.10, U6.5 (A3)
A12: J1.6, U6.6 (A4)
A13: J1.5, U6.7 (A5)
A14: J1.9, U6.8 (A6)
A15: J1.8, U6.9 (A7)
AA0: U2.10 (A0), U3.21 (GPA0), U5.18 (B0), U8.1 (CLK/IN)
AA1: U2.9 (A1), U3.22 (GPA1), U5.17 (B1), U8.2 (IN)
AA2: U2.8 (A2), U3.23 (GPA2), U5.16 (B2), U8.3 (IN)
AA3: U2.7 (A3), U3.24 (GPA3), U5.15 (B3), U8.4 (IN/PD)
AA4: U2.6 (A4), U3.25 (GPA4), U5.14 (B4), U8.5 (IN)
AA5: U2.5 (A5), U3.26 (GPA5), U5.13 (B5), U8.6 (IN)
AA6: U2.4 (A6), U3.27 (GPA6), U5.12 (B6), U8.7 (IN)
AA7: U2.3 (A7), U3.28 (GPA7), U5.11 (B7), U8.8 (IN)
AA8: U2.25 (A8), U3.1 (GPB0), U6.18 (B0), U8.9 (IN)
AA9: U2.24 (A9), U3.2 (GPB1), U6.17 (B1), U8.10 (IN)
AA10: U2.21 (A10), U3.3 (GPB2), U6.16 (B2), U8.11 (IN)
AA11: U2.23 (A11), U3.4 (GPB3), U6.15 (B3), U8.13 (IN)
AA12: U2.2 (A12), U3.5 (GPB4), U6.14 (B4), U8.14 (I/O)
AA13: U2.26 (A13), U3.6 (GPB5), U6.13 (B5), U8.15 (I/O)
AA14: U2.1 (A14), U3.7 (GPB6), U6.12 (B6), U8.16 (I/O)
AA15: U3.8 (GPB7), U6.11 (B7), U8.17 (I/O)
ADDR_0: U8.20 (I/O), U9.3 (I2)
ADDR_1: U8.21 (I/O), U9.4 (I3)
ADDR_2: U8.22 (I/O), U9.5 (I4)
ADDR_FREHD: U8.19 (I/O), U9.2 (I1)
ADDR_TRS_IO: U8.18 (I/O), U9.1 (I/CLK)
BUTTON: R4.2, SW1.2, U1.23 (GPIO39)
CAS_N: J1.4
CS23S17: U1.29 (GPIO26), U3.11 (~CS~)
D0: J1.29, U4.2 (A0)
D1: J1.21, U4.3 (A1)
D2: J1.31, U4.4 (A2)
D3: J1.25, U4.5 (A3)
D4: J1.17, U4.6 (A4)
D5: J1.27, U4.7 (A5)
D6: J1.23, U4.8 (A6)
D7: J1.19, U4.9 (A7)
DBUS_SEL_N: U4.19 (CE), U9.15 (I/O)
DD0: U1.32 (GPIO12), U2.11 (DQ0), U4.18 (B0)
DD1: U1.34 (GPIO13), U2.12 (DQ1), U4.17 (B1)
DD2: U1.31 (GPIO14), U2.13 (DQ2), U4.16 (B2)
DD3: U1.4 (GPIO15), U2.15 (DQ3), U4.15 (B3)
DD4: U1.8 (GPIO16), U2.16 (DQ4), U4.14 (B4)
DD5: U1.9 (GPIO17), U2.17 (DQ5), U4.13 (B5)
DD6: U1.11 (GPIO18), U2.18 (DQ6), U4.12 (B6)
DD7: U1.12 (GPIO19), U2.19 (DQ7), U4.11 (B7)
ESP3_SEL_N: U1.18 (GPIO23), U7.18 (B0)
ESP_INT: Q2.2 (G), U1.27 (GPIO33)
ESP_MISO: U1.17 (GPIO22), U7.16 (B2)
ESP_READ_N: U1.22 (GPIO36), U7.17 (B1)
ESP_S0: U1.24 (GPIO34), U7.15 (B3)
ESP_S1: U1.25 (GPIO35), U7.14 (B4)
ESP_SEL_N: U7.2 (A0), U9.14 (I/O)
ESP_WAIT_RELEASE_N: U1.30 (GPIO27), U9.11 (I9/~OE)
GND: C1.2, C2.2, C3.2, C4.2, C5.2, C6.2, C7.2, C8.2, D1.2 (K), J1.7, J1.30, J1.38, Q1.1 (S), Q2.1 (S), SW1.1, U1.13 (GND), U1.19 (GND), U1.33 (GND), U2.14 (GND), U2.20 (~CE), U3.10 (VSS), U3.15 (A0), U3.16 (A1), U3.17 (A2), U4.10 (GND), U5.10 (GND), U5.19 (CE), U6.10 (GND), U6.19 (CE), U7.10 (GND), U7.19 (CE), U8.12 (GND), U9.10 (GND)
INTACK_N: J1.13
INT_N: J1.22, Q2.3 (D)
IN_N: J1.20, U9.8 (I7)
LED_BLUE: R3.1, U1.26 (GPIO32)
LED_GREEN: R2.1, U1.7 (GPIO4)
LED_RED: R1.1, U1.10 (GPIO5)
MISO: U3.14 (SO), U7.4 (A2)
MOSI: U1.14 (GPIO21), U3.13 (SI)
MUX: J1.15
unnamed: D1.1 (RA), R1.2
unnamed: D1.3 (BA), R3.2
unnamed: D1.4 (GA), R2.2
OUT_N: J1.11, U9.9 (I8)
RAS_N: J1.2
RD_N: J1.16, U9.6 (I5)
READ_N: U4.1 (A->B), U7.3 (A1), U9.13 (I/O)
S0: U7.5 (A3), U9.16 (I/O)
S1: U7.6 (A4), U9.17 (I/O)
SCK: U1.28 (GPIO25), U3.12 (SCK)
SRAM_OE_N: U2.22 (~OE), U9.18 (I/O)
SRAM_WE_N: U2.27 (~WE), U9.19 (I/O)
SYSRES_N: J1.1
TEST_N: J1.24
WAIT: Q1.2 (G), U9.12 (I/O)
WAIT_N: J1.34, Q1.3 (D)
WR_N: J1.14, U9.7 (I6)

Notes on the sheet:
Note: the pin numbers do NOT correspond with the pinout of the M1 expansion interface because of the non-standard numbering used for the M1.

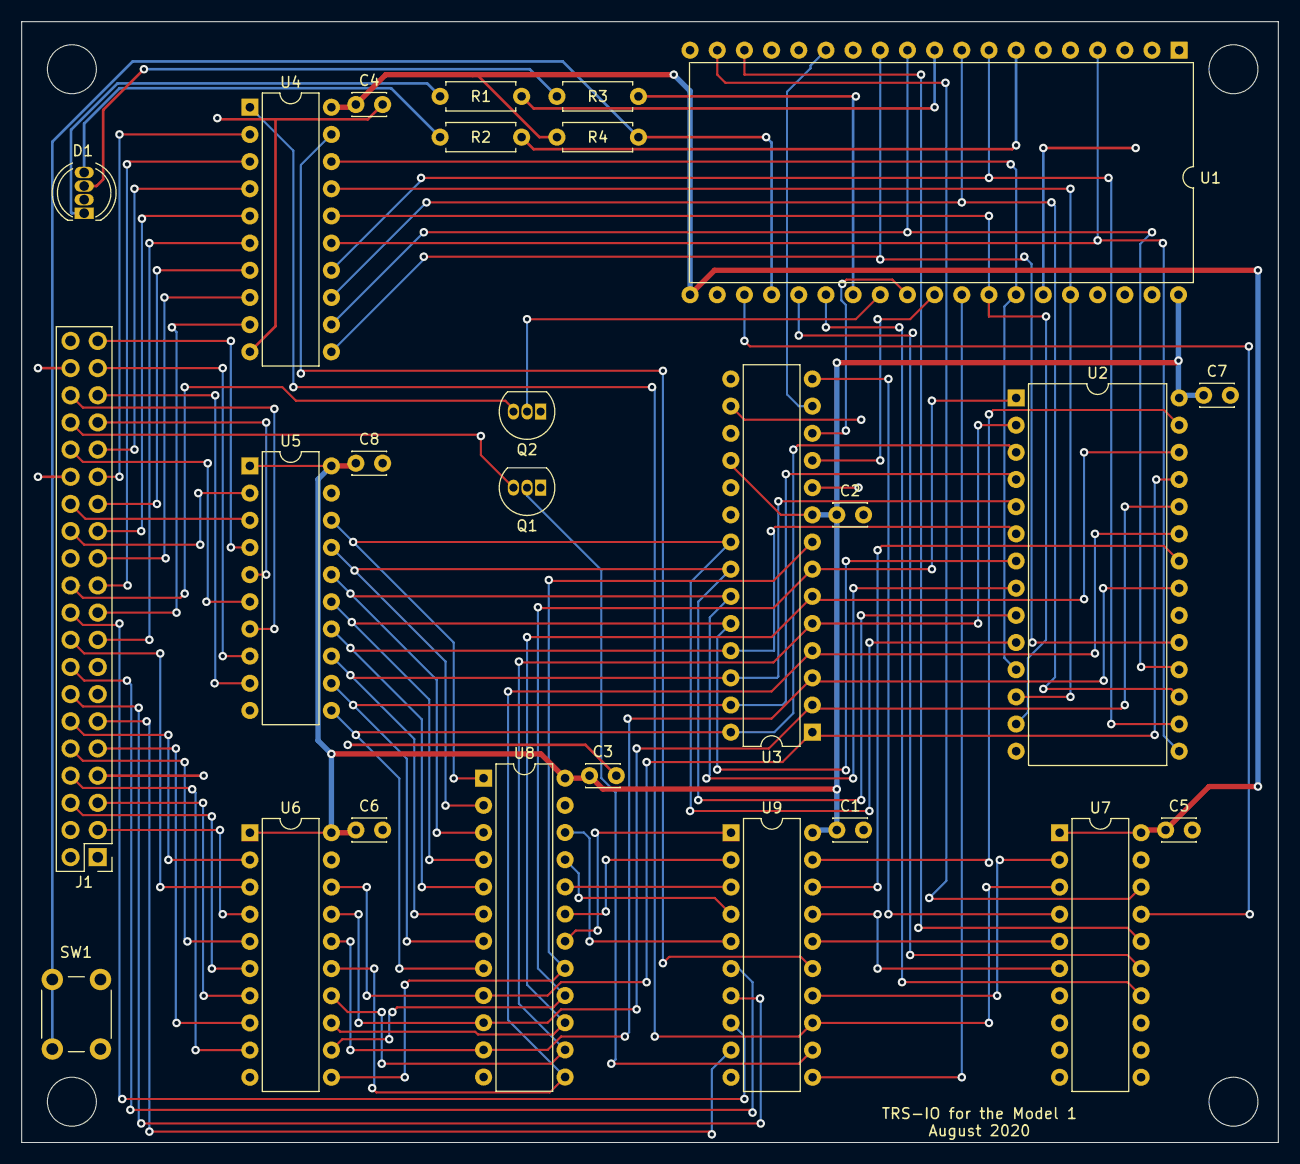
[picture p18: board kicad/m1/v1/TRS-IO-M1.kicad_pcb from above]

Board: 2 copper layers, 117.5 x 104.8 mm, 26 parts (0 on the bottom side), 88 nets.
